lzptr/stm_audioboard/README.md

# stm_audioboard
STM32 based mixed signal audio board from phils lab mixed signal course (https://www.phils-lab.net/courses).
