lzptr/stm_audioboard/hardware/production/stm_audioboard-pcb.pdf

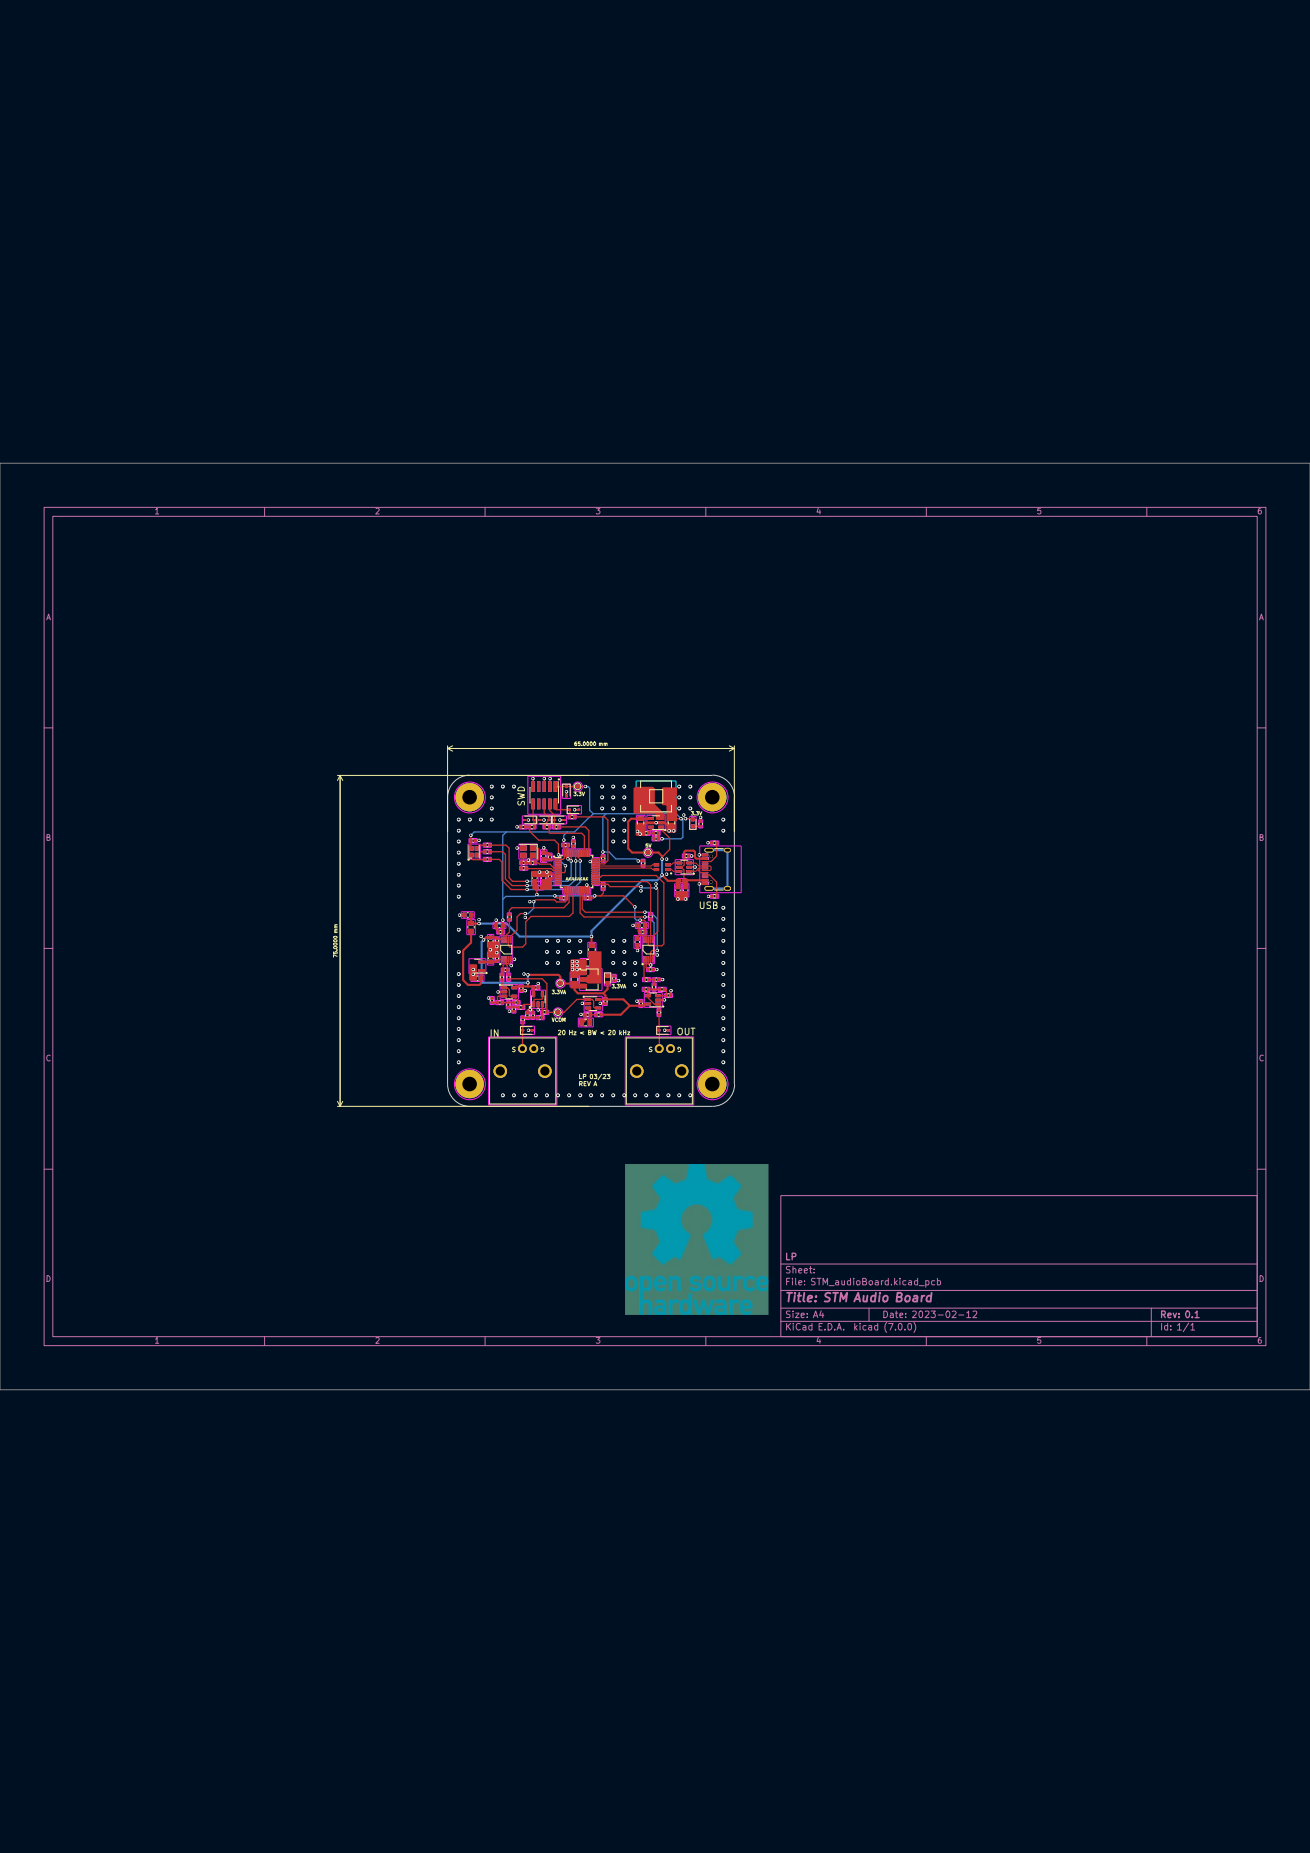
[picture p1: page 1]
