lzptr/stm_audioboard/hardware/STM_audioBoard.kicad_pcb

## KiCad design hardware/STM_audioBoard.kicad_pcb (2023-04-19)

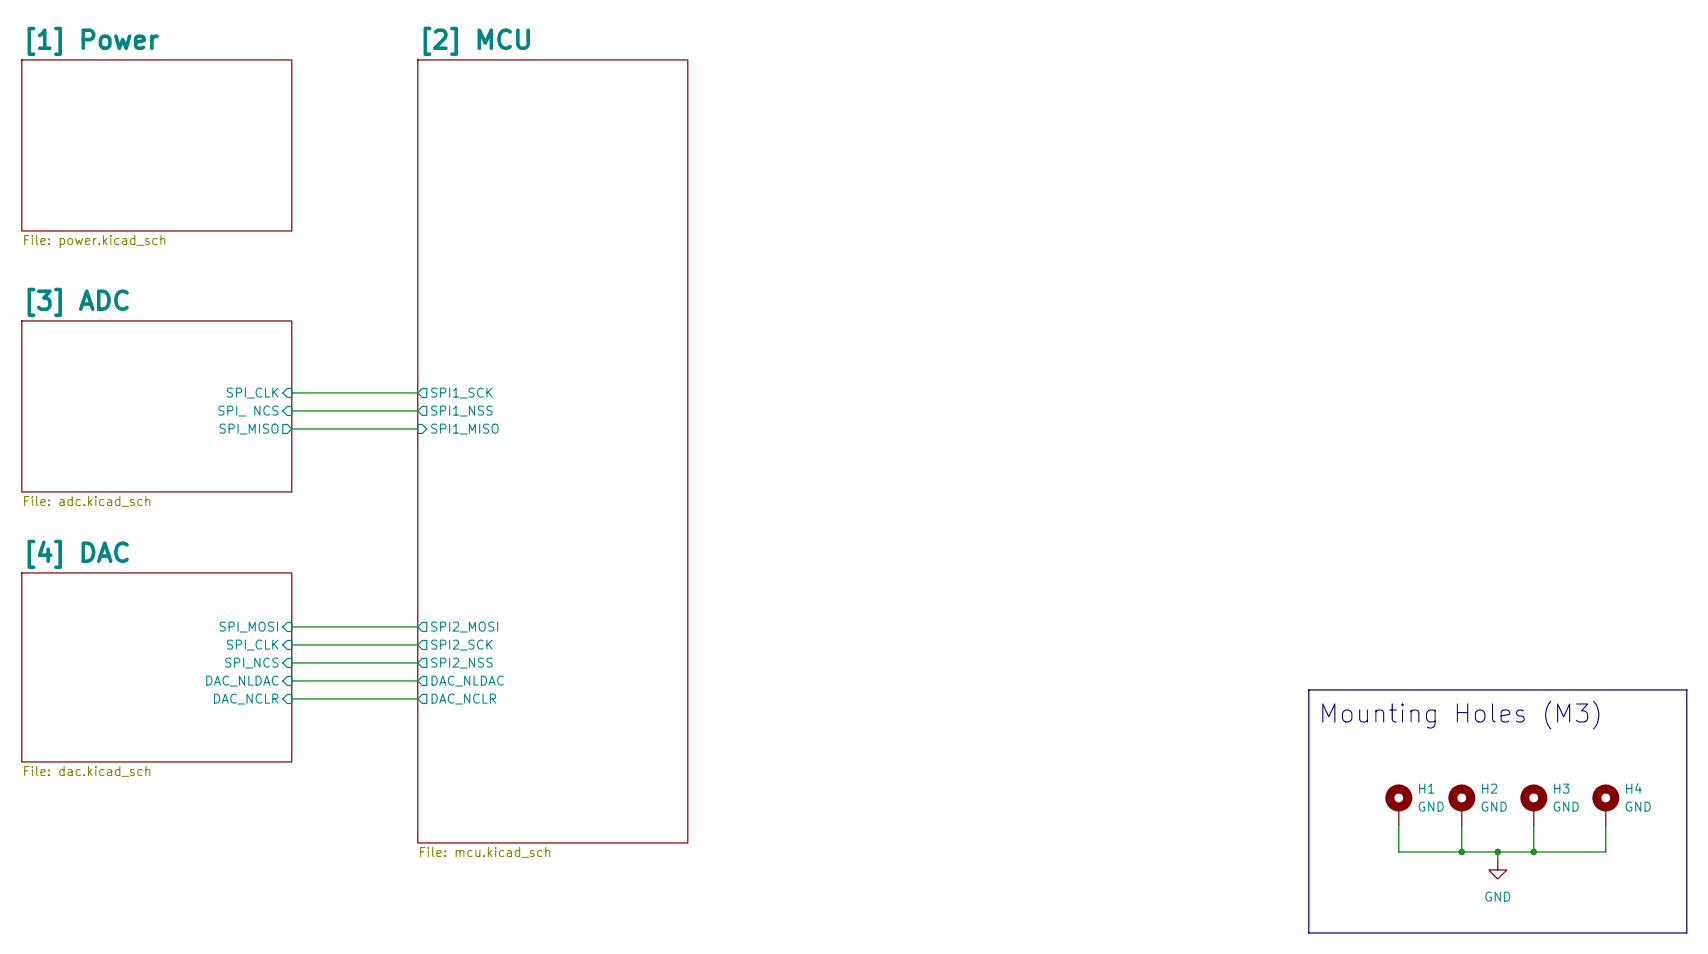
[picture p7: schematic STM_audioBoard.kicad_sch, STM Audio Board]

Parts:
H1, H2, H3, H4: GND; MountingHole_3.2mm_M3_Pad

Connections:
GND: H1.1, H2.1, H3.1, H4.1; also elsewhere on the board

Notes on the sheet:
Mounting Holes (M3)

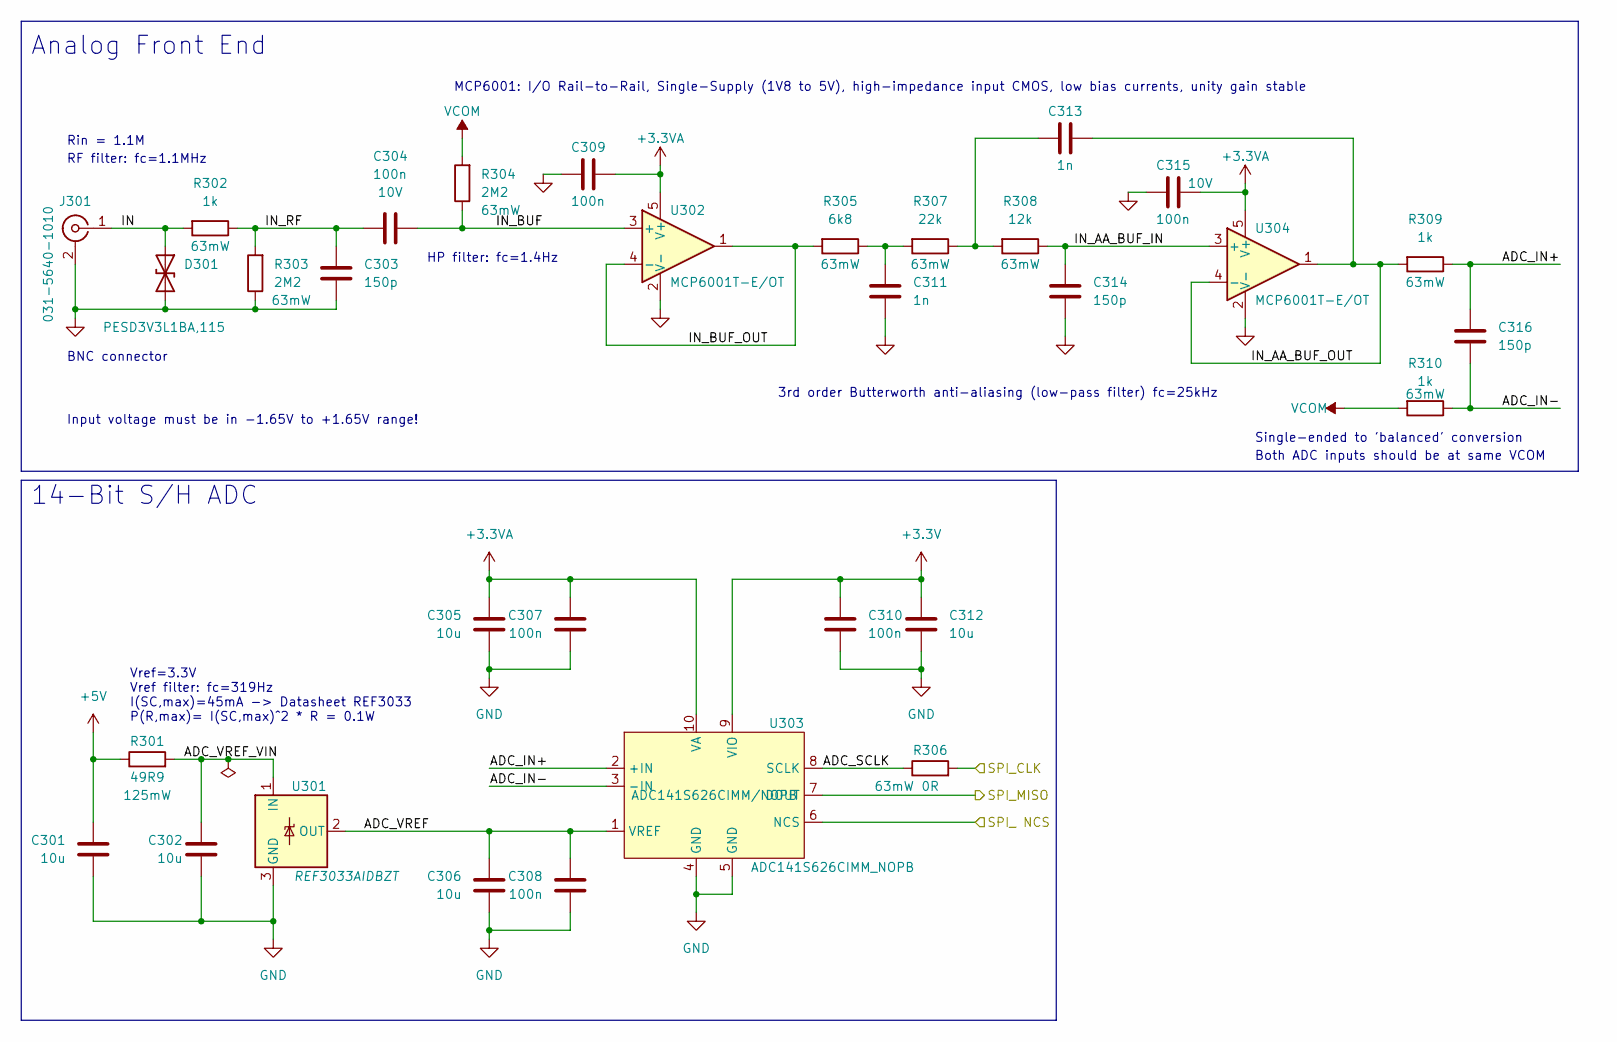
[picture p8: schematic adc.kicad_sch, STM Audio Board]

Parts:
C301, C302, C305, C306, C312: 10u; C_0603_1608Metric
C303, C314, C316: 150p; C_0402_1005Metric
C304, C307, C308, C309, C310, C315: 100n; C_0402_1005Metric; Rating 10V; MPN CC0402KRX5R6BB104
C311, C313: 1n; C_0402_1005Metric
D301: PESD3V3L1BA,115; D_SOD-323
J301: 031-5640-1010; AMPHENOL-BNC-031-5640-1010
R301: 49R9; R_0805_2012Metric; Rating 125mW
R302, R309, R310: 1k; R_0402_1005Metric; Rating 63mW
R303, R304: 2M2; R_0402_1005Metric; Rating 63mW
R305: 6k8; R_0402_1005Metric; Rating 63mW
R306: 0R; R_0402_1005Metric; Rating 63mW
R307: 22k; R_0402_1005Metric; Rating 63mW
R308: 12k; R_0402_1005Metric; Rating 63mW
U301: REF3033AIDBZT; SOT-23
U302, U304: MCP6001T-E/OT; SOT-23-5
U303: ADC141S626CIMM_NOPB; VSSOP-10; MPN ADC141S626CIMM/NOPB

Connections:
+3.3V: C310.1, C312.1, U303.9 (VIO); also elsewhere on the board
+3.3VA: C305.1, C307.1, C309.1, C315.1, U302.5 (V+), U303.10 (VA), U304.5 (V+); also elsewhere on the board
+5V: C301.1, R301.1; also elsewhere on the board
/[2] MCU/SPI1_MISO: U303.7 (DOUT); also elsewhere on the board
/[2] MCU/SPI1_NSS: U303.6 (NCS); also elsewhere on the board
/[2] MCU/SPI1_SCK: R306.2; also elsewhere on the board
/[3] ADC/ADC_IN+: C316.1, R309.1, U303.2 (+IN)
/[3] ADC/ADC_IN-: C316.2, R310.1, U303.3 (-IN)
/[3] ADC/ADC_SCLK: R306.1, U303.8 (SCLK)
/[3] ADC/ADC_VREF: C306.1, C308.1, U301.2 (OUT), U303.1 (VREF)
/[3] ADC/ADC_VREF_VIN: C302.1, R301.2, U301.1 (IN)
/[3] ADC/IN: D301.1 (A1), J301.1 (In), R302.2
/[3] ADC/IN_AA_BUF_IN: C314.1, R308.1, U304.3 (+)
/[3] ADC/IN_AA_BUF_OUT: C313.2, R309.2, U304.1, U304.4 (-)
/[3] ADC/IN_BUF: C304.1, R304.1, U302.3 (+)
/[3] ADC/IN_BUF_OUT: R305.2, U302.1, U302.4 (-)
/[3] ADC/IN_RF: C303.1, C304.2, R302.1, R303.2
GND: C301.2, C302.2, C303.2, C305.2, C306.2, C307.2, C308.2, C309.2, C310.2, C311.2, C312.2, C314.2, C315.2, D301.2 (A2), J301.2 (Ext), R303.1, U301.3 (GND), U302.2 (V-), U303.4 (GND), U303.5 (GND), U304.2 (V-); also elsewhere on the board
unnamed: C311.1, R305.1, R307.2
unnamed: C313.1, R307.1, R308.2
VCOM: R304.2, R310.2; also elsewhere on the board

Notes on the sheet:
RF filter: fc=1.1MHz
3rd order Butterworth anti-aliasing (low-pass filter) fc=25kHz
BNC connector
14-Bit S/H ADC
HP filter: fc=1.4Hz
Rin = 1.1M
MCP6001: I/O Rail-to-Rail, Single-Supply (1V8 to 5V), high-impedance input CMOS, low bias currents, unity gain stable
Input voltage must be in -1.65V to +1.65V range!
Vref=3.3V Vref filter: fc=319Hz I(SC,max)=45mA -> Datasheet REF3033 P(R,max)= I(SC,max)^2 * R = 0.1W
Analog Front End
Both ADC inputs should be at same VCOM
Single-ended to 'balanced' conversion

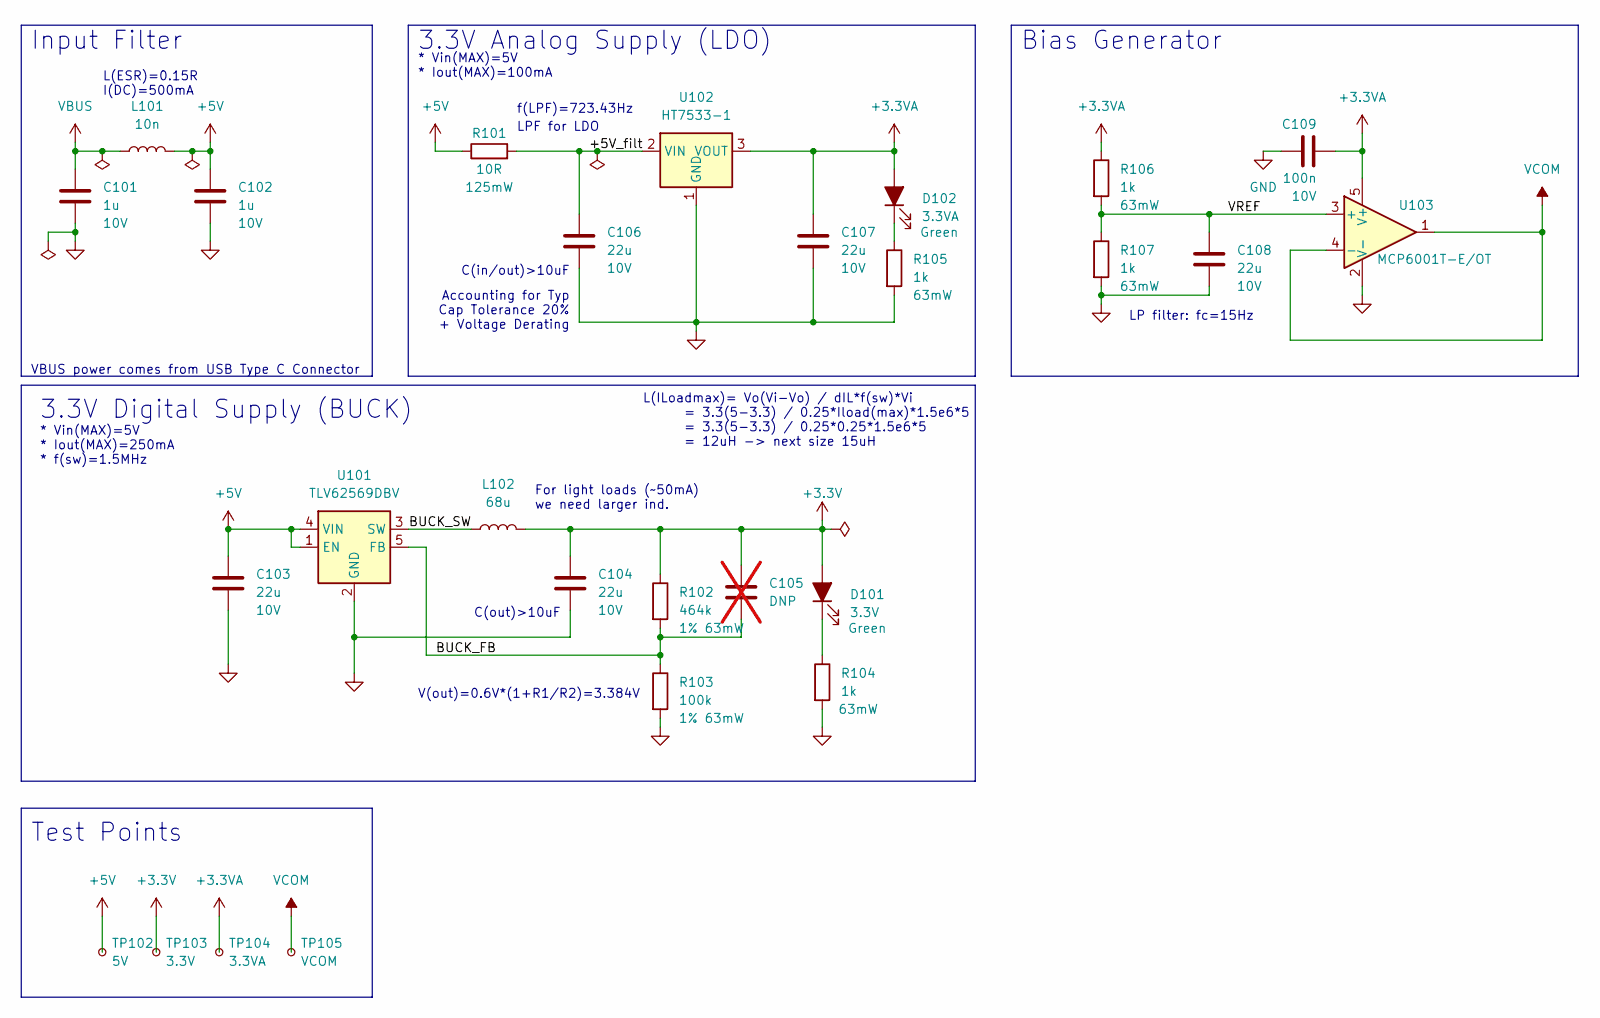
[picture p9: schematic power.kicad_sch, STM Audio Board]

Parts:
C101, C102: 1u; C_0603_1608Metric; Rating 10V; MPN CC0603KRX5R6BB105
C103, C104, C106, C107, C108: 22u; C_0805_2012Metric; Rating 10V; MPN CC0805KRX5R6BB225
C105: DNP; C_0402_1005Metric; Rating 10V; not fitted
C109: 100n; C_0402_1005Metric; Rating 10V; MPN CC0402KRX5R6BB104
D101: 3.3V; LED_0603_1608Metric; Rating Green
D102: 3.3VA; LED_0603_1608Metric; Rating Green
L101: 10n; L_0402_1005Metric
L102: 68u; MWSA0603S
R101: 10R; R_0805_2012Metric; Rating 125mW
R102: 464k; R_0402_1005Metric; Rating 1% 63mW
R103: 100k; R_0402_1005Metric; Rating 1% 63mW
R104, R105, R106, R107: 1k; R_0402_1005Metric; Rating 63mW
TP102: 5V; TestPoint_Pad_D1.0mm
TP103: 3.3V; TestPoint_Pad_D1.0mm
TP104: 3.3VA; TestPoint_Pad_D1.0mm
TP105: VCOM; TestPoint_Pad_D1.0mm
U101: TLV62569DBV; SOT-23-5
U102: HT7533-1; SOT-89-3
U103: MCP6001T-E/OT; SOT-23-5

Connections:
+3.3V: C104.1, C105.1, D101.2 (A), L102.2, R102.1, TP103.1; also elsewhere on the board
+3.3VA: C107.1, C109.2, D102.2 (A), R106.1, TP104.1, U102.3 (VOUT), U103.5 (V+); also elsewhere on the board
+5V: C102.1, C103.1, L101.2, R101.1, TP102.1, U101.1 (EN), U101.4 (VIN); also elsewhere on the board
/[1] Power/+5V_filt: C106.1, R101.2, U102.2 (VIN)
/[1] Power/BUCK_FB: C105.2, R102.2, R103.1, U101.5 (FB)
/[1] Power/BUCK_SW: L102.1, U101.3 (SW)
/[1] Power/VREF: C108.1, R106.2, R107.1, U103.3 (+)
GND: C101.2, C102.2, C103.2, C104.2, C106.2, C107.2, C108.2, C109.1, R103.2, R104.2, R105.2, R107.2, U101.2 (GND), U102.1 (GND), U103.2 (V-); also elsewhere on the board
unnamed: D101.1 (K), R104.1
unnamed: D102.1 (K), R105.1
VBUS: C101.1, L101.1; also elsewhere on the board
VCOM: TP105.1, U103.1, U103.4 (-); also elsewhere on the board

Notes on the sheet:
* Vin(MAX)=5V * Iout(MAX)=100mA
Test Points
3.3V Digital Supply (BUCK)
For light loads (~50mA) we need larger ind.
Input Filter
V(out)=0.6V*(1+R1/R2)=3.384V
LP filter: fc=15Hz
Accounting for Typ Cap Tolerance 20% + Voltage Derating
3.3V Analog Supply (LDO)
C(out)>10uF
* Vin(MAX)=5V * Iout(MAX)=250mA * f(sw)=1.5MHz
L(ILoadmax)= Vo(Vi-Vo) / dIL*f(sw)*Vi = 3.3(5-3.3) / 0.25*Iload(max)*1.5e6*5 = 3.3(5-3.3) / 0.25*0.25*1.5e6*5 = 12uH -> next size 15uH
L(ESR)=0.15R I(DC)=500mA
f(LPF)=723.43Hz
Bias Generator
C(in/out)>10uF
VBUS power comes from USB Type C Connector
LPF for LDO

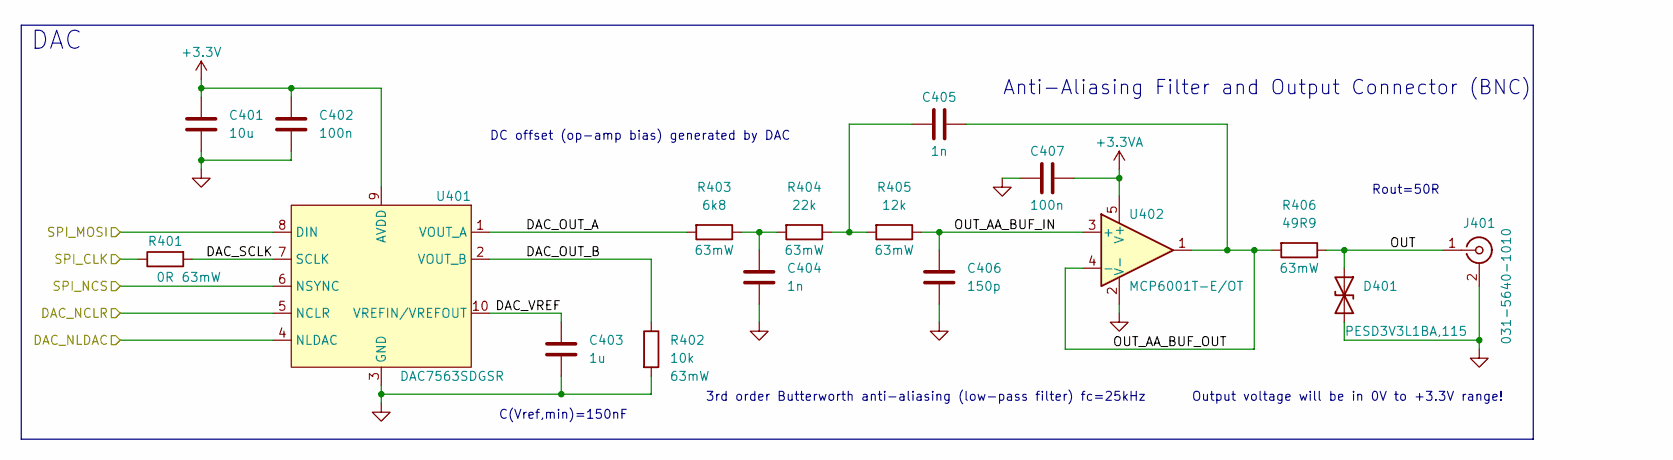
[picture p10: schematic dac.kicad_sch, STM Audio Board]

Parts:
C401: 10u; C_0603_1608Metric
C402, C407: 100n; C_0402_1005Metric; Rating 10V; MPN CC0402KRX5R6BB104
C403: 1u; C_0603_1608Metric; Rating 10V; MPN CC0603KRX5R6BB105
C404, C405: 1n; C_0402_1005Metric
C406: 150p; C_0402_1005Metric
D401: PESD3V3L1BA,115; D_SOD-323
J401: 031-5640-1010; AMPHENOL-BNC-031-5640-1010
R401: 0R; R_0402_1005Metric; Rating 63mW
R402: 10k; R_0402_1005Metric; Rating 63mW
R403: 6k8; R_0402_1005Metric; Rating 63mW
R404: 22k; R_0402_1005Metric; Rating 63mW
R405: 12k; R_0402_1005Metric; Rating 63mW
R406: 49R9; R_0402_1005Metric; Rating 63mW
U401: DAC7563SDGSR; VSSOP-10; MPN DAC7563SDGSR
U402: MCP6001T-E/OT; SOT-23-5

Connections:
+3.3V: C401.1, C402.1, U401.9 (AVDD); also elsewhere on the board
+3.3VA: C407.1, U402.5 (V+); also elsewhere on the board
/[2] MCU/DAC_NCLR: U401.5 (NCLR); also elsewhere on the board
/[2] MCU/DAC_NLDAC: U401.4 (NLDAC); also elsewhere on the board
/[2] MCU/SPI2_MOSI: U401.8 (DIN); also elsewhere on the board
/[2] MCU/SPI2_NSS: U401.6 (NSYNC); also elsewhere on the board
/[2] MCU/SPI2_SCK: R401.1; also elsewhere on the board
/[4] DAC/DAC_OUT_A: R403.2, U401.1 (VOUT_A)
/[4] DAC/DAC_OUT_B: R402.1, U401.2 (VOUT_B)
/[4] DAC/DAC_SCLK: R401.2, U401.7 (SCLK)
/[4] DAC/DAC_VREF: C403.1, U401.10 (VREFIN/VREFOUT)
/[4] DAC/OUT: D401.1 (A1), J401.1 (In), R406.1
/[4] DAC/OUT_AA_BUF_IN: C406.1, R405.1, U402.3 (+)
/[4] DAC/OUT_AA_BUF_OUT: C405.2, R406.2, U402.1, U402.4 (-)
GND: C401.2, C402.2, C403.2, C404.2, C406.2, C407.2, D401.2 (A2), J401.2 (Ext), R402.2, U401.3 (GND), U402.2 (V-); also elsewhere on the board
unnamed: C404.1, R403.1, R404.2
unnamed: C405.1, R404.1, R405.2

Notes on the sheet:
DC offset (op-amp bias) generated by DAC
Rout=50R
Output voltage will be in 0V to +3.3V range!
C(Vref,min)=150nF
Anti-Aliasing Filter and Output Connector (BNC)
3rd order Butterworth anti-aliasing (low-pass filter) fc=25kHz
DAC

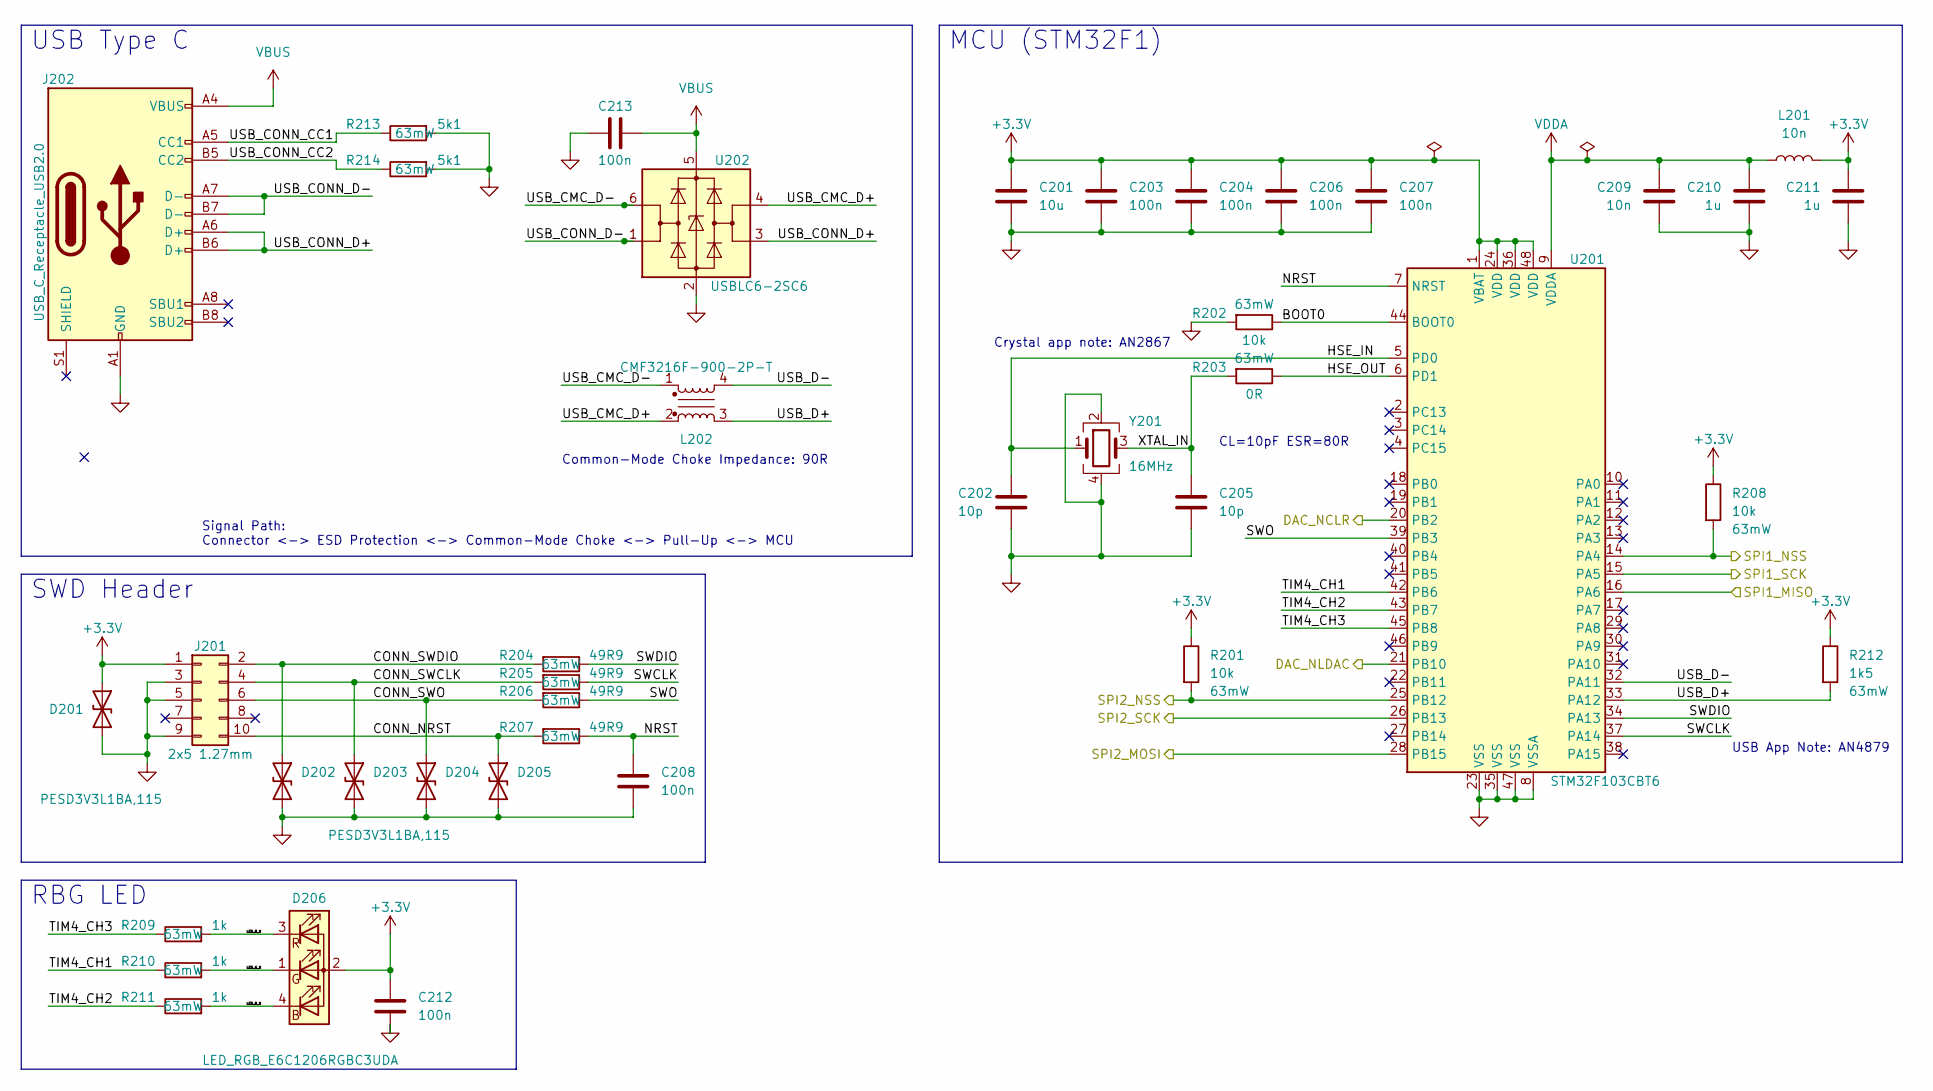
[picture p11: schematic mcu.kicad_sch, STM Audio Board]

Parts:
C201: 10u; C_0603_1608Metric
C202, C205: 10p; C_0402_1005Metric
C203, C204, C206, C207, C208, C212, C213: 100n; C_0402_1005Metric; Rating 10V; MPN CC0402KRX5R6BB104
C209: 10n; C_0402_1005Metric
C210, C211: 1u; C_0603_1608Metric; Rating 10V; MPN CC0603KRX5R6BB105
D201, D202, D203, D204, D205: PESD3V3L1BA,115; D_SOD-323
D206: LED_RGB_E6C1206RGBC3UDA; LED_Cree-PLCC4_2x2mm_CW
J201: 2x5 1.27mm; PinHeader_2x05_P1.27mm_Vertical_SMD
J202: USB_C_Receptacle_USB2.0; USB_C_Receptacle_HRO_TYPE-C-31-M-12
L201: 10n; L_0402_1005Metric
L202: CMF3216F-900-2P-T; CMC-1206
R201, R202, R208: 10k; R_0402_1005Metric; Rating 63mW
R203: 0R; R_0402_1005Metric; Rating 63mW
R204, R205, R206, R207: 49R9; R_0402_1005Metric; Rating 63mW
R209, R210, R211: 1k; R_0402_1005Metric; Rating 63mW
R212: 1k5; R_0402_1005Metric; Rating 63mW
R213, R214: 5k1; R_0402_1005Metric; Rating 63mW
U201: STM32F103CBT6; LQFP-48_7x7mm_P0.5mm; Manufacturer Part Number STM32F103CBT6
U202: USBLC6-2SC6; SOT-23-6
Y201: 16MHz; Crystal_SMD_3225-4Pin_3.2x2.5mm

Connections:
+3.3V: C201.1, C203.1, C204.1, C206.1, C207.1, C211.1, C212.1, D201.1 (A1), D206.2 (A), J201.1, L201.2, R201.1, R208.1, R212.1, U201.1 (VBAT), U201.24 (VDD), U201.36 (VDD), U201.48 (VDD); also elsewhere on the board
/[2] MCU/BOOT0: R202.1, U201.44 (BOOT0)
/[2] MCU/CONN_NRST: D205.1 (A1), J201.10, R207.2
/[2] MCU/CONN_SWCLK: D203.1 (A1), J201.4, R205.2
/[2] MCU/CONN_SWDIO: D202.1 (A1), J201.2, R204.2
/[2] MCU/CONN_SWO: D204.1 (A1), J201.6, R206.2
/[2] MCU/DAC_NCLR: U201.20 (PB2); also elsewhere on the board
/[2] MCU/DAC_NLDAC: U201.21 (PB10); also elsewhere on the board
/[2] MCU/HSE_IN: C202.1, U201.5 (PD0), Y201.1
/[2] MCU/HSE_OUT: R203.1, U201.6 (PD1)
/[2] MCU/LED_B_K: D206.4 (BK), R211.2
/[2] MCU/LED_G_K: D206.1 (GK), R210.2
/[2] MCU/LED_R_K: D206.3 (RK), R209.2
/[2] MCU/NRST: C208.1, R207.1, U201.7 (NRST)
/[2] MCU/SPI1_MISO: U201.16 (PA6); also elsewhere on the board
/[2] MCU/SPI1_NSS: R208.2, U201.14 (PA4); also elsewhere on the board
/[2] MCU/SPI1_SCK: U201.15 (PA5); also elsewhere on the board
/[2] MCU/SPI2_MOSI: U201.28 (PB15); also elsewhere on the board
/[2] MCU/SPI2_NSS: R201.2, U201.25 (PB12); also elsewhere on the board
/[2] MCU/SPI2_SCK: U201.26 (PB13); also elsewhere on the board
/[2] MCU/SWCLK: R205.1, U201.37 (PA14)
/[2] MCU/SWDIO: R204.1, U201.34 (PA13)
/[2] MCU/SWO: R206.1, U201.39 (PB3)
/[2] MCU/TIM4_CH1: R210.1, U201.42 (PB6)
/[2] MCU/TIM4_CH2: R211.1, U201.43 (PB7)
/[2] MCU/TIM4_CH3: R209.1, U201.45 (PB8)
/[2] MCU/USB_CMC_D+: L202.2, U202.4 (I/O2)
/[2] MCU/USB_CMC_D-: L202.1, U202.6 (I/O1)
/[2] MCU/USB_CONN_CC1: J202.A5 (CC1), R213.1
/[2] MCU/USB_CONN_CC2: J202.B5 (CC2), R214.1
/[2] MCU/USB_CONN_D+: J202.A6 (D+), J202.B6 (D+), U202.3 (I/O2)
/[2] MCU/USB_CONN_D-: J202.A7 (D-), J202.B7 (D-), U202.1 (I/O1)
/[2] MCU/USB_D+: L202.3, R212.2, U201.33 (PA12)
/[2] MCU/USB_D-: L202.4, U201.32 (PA11)
/[2] MCU/XTAL_IN: C205.1, R203.2, Y201.3
GND: C201.2, C202.2, C203.2, C204.2, C205.2, C206.2, C207.2, C208.2, C209.2, C210.2, C211.2, C212.2, C213.2, D201.2 (A2), D202.2 (A2), D203.2 (A2), D204.2 (A2), D205.2 (A2), J201.3, J201.5, J201.9, J202.A1 (GND), J202.A12 (GND), J202.B1 (GND), J202.B12 (GND), R202.2, R213.2, R214.2, U201.8 (VSSA), U201.23 (VSS), U201.35 (VSS), U201.47 (VSS), U202.2 (GND), Y201.2, Y201.4; also elsewhere on the board
VBUS: C213.1, J202.A4 (VBUS), J202.A9 (VBUS), J202.B4 (VBUS), J202.B9 (VBUS), U202.5 (VBUS); also elsewhere on the board
VDDA: C209.1, C210.1, L201.1, U201.9 (VDDA)

Notes on the sheet:
USB Type C
CL=10pF ESR=80R
USB App Note: AN4879
RBG LED
Signal Path: Connector <-> ESD Protection <-> Common-Mode Choke <-> Pull-Up <-> MCU
SWD Header
Crystal app note: AN2867
Common-Mode Choke Impedance: 90R
MCU (STM32F1)

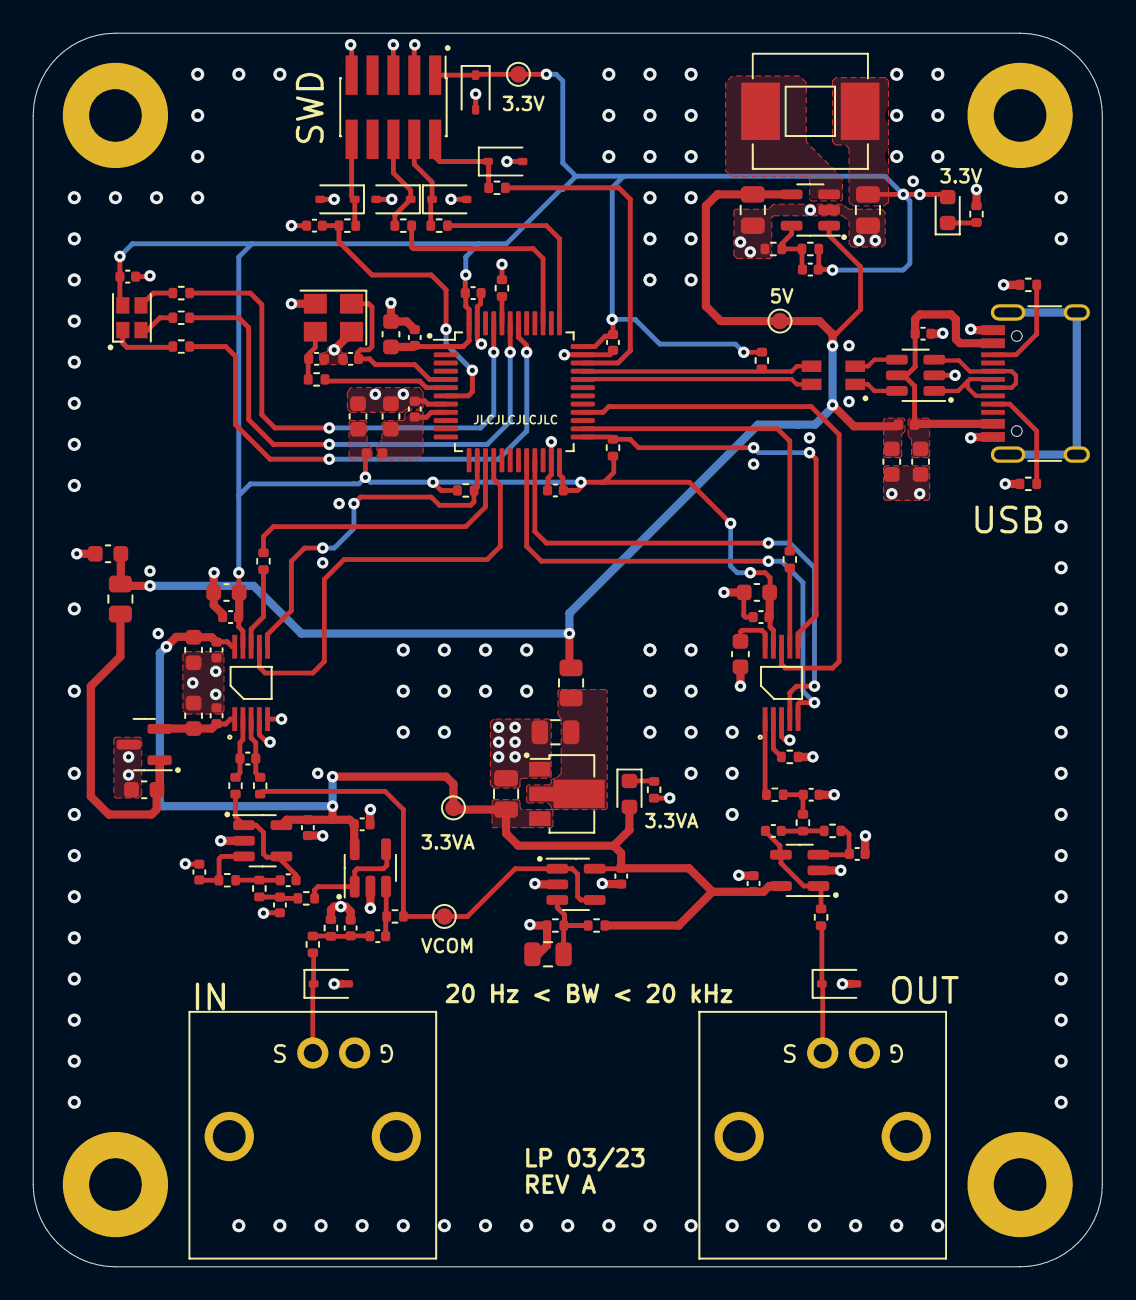
[picture p12: board STM_audioBoard.kicad_pcb from above]

Board: 4 copper layers, 65.0 x 75.0 mm, 120 parts (0 on the bottom side), 69 nets.
